ddszatkowski/Automated-Gardening-System/EE-CpE 4097 Automated Gardening System - Final Presentation.pdf

# Automated Gardening System (AGS)

# EE-CpE 4097

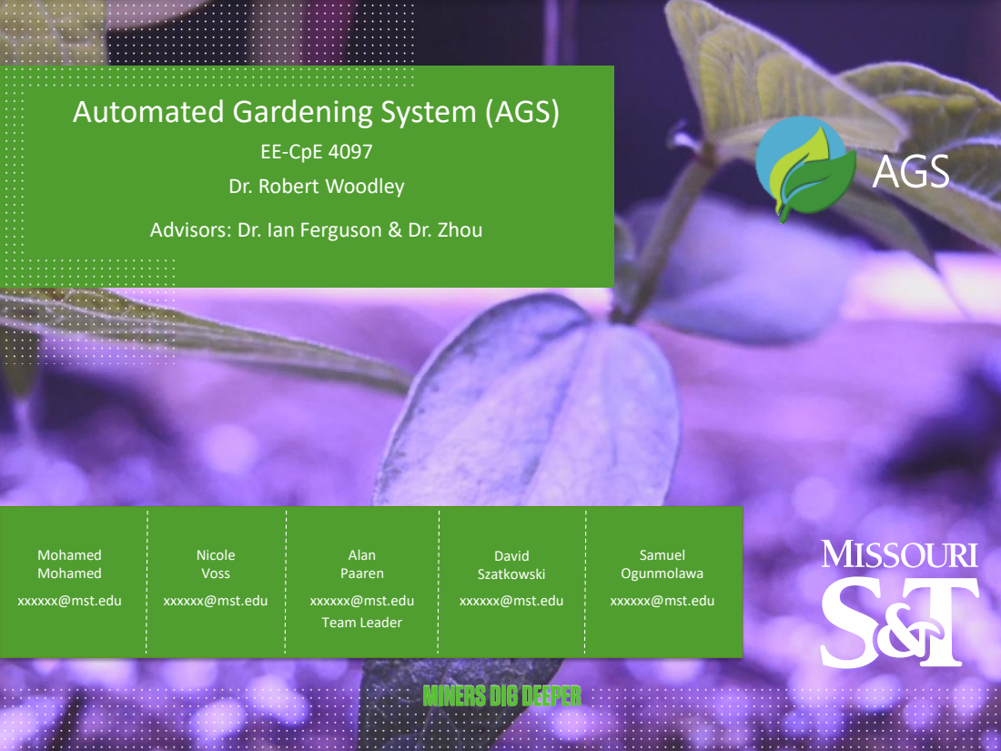
[picture p36: page 1]
AGS

Dr. Robert Woodley

Advisors: Dr. Ian Ferguson & Dr. Zhou

Mohamed
xxxxxx@mst.edu

Nicole
Voss

Alan
Paaren
Team Leader

David
Szatkowski

Samuel
Ogunmolawa

- Overview – Goals – Motivation – Value • Progress – Entire System – Sound Frequency System – Ventilation System – Lighting System – Watering System – Nutrient Dosing System – User Interface • Results – Plant Visuals – Graphs • Lessons Learned • References

# OUTLINE

EE

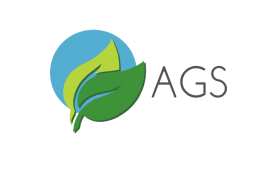
[picture p37: figure]

-CpE 4097 | AGS

2

OVERVIEW | AGS

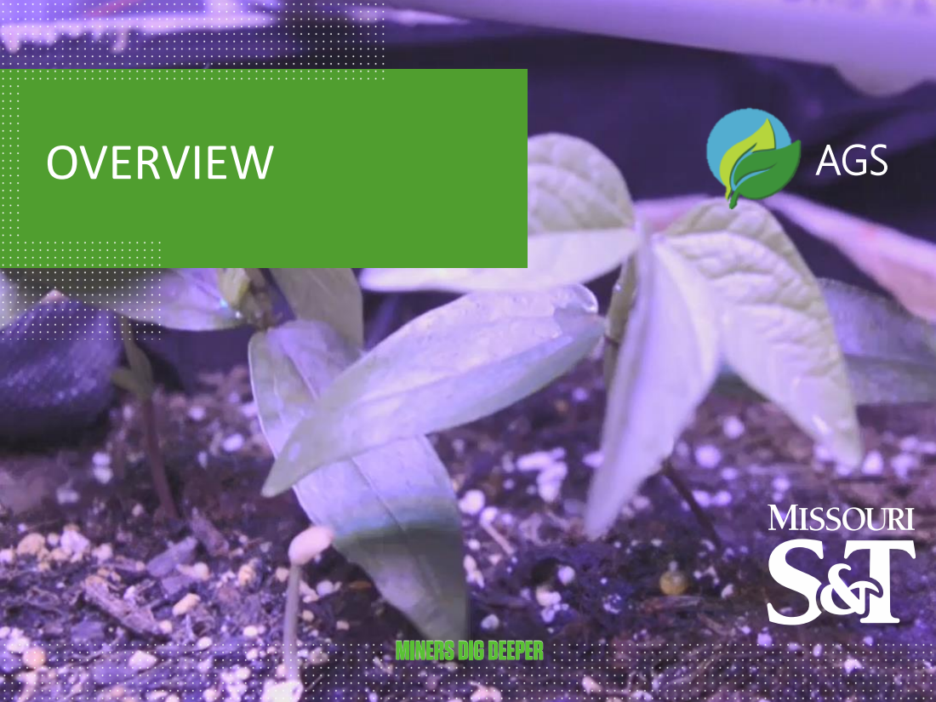
[picture p38: page 3]

# OVERVIEW - GOALS

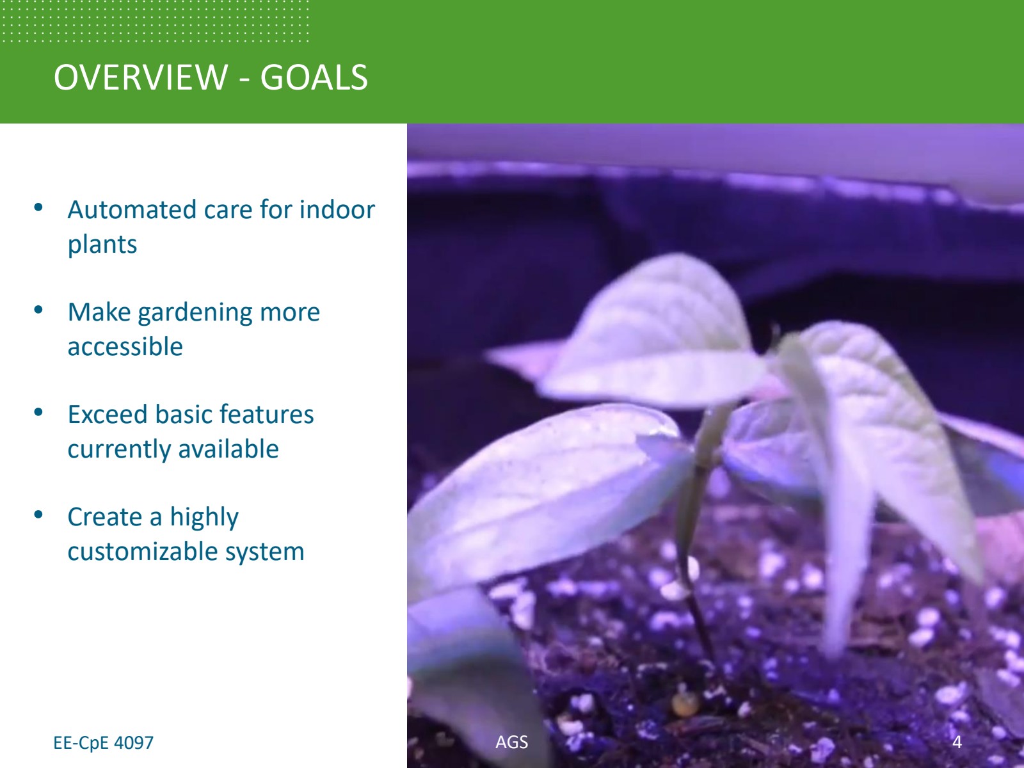
[picture p39: page 4]

# - Automated care for indoor plants

# - Make gardening more accessible

# - Exceed basic features currently available

# - Create a highly customizable system

EE-CpE 4097 | AGS | 4

# OVERVIEW - MOTIVATION

# - Increased demand for

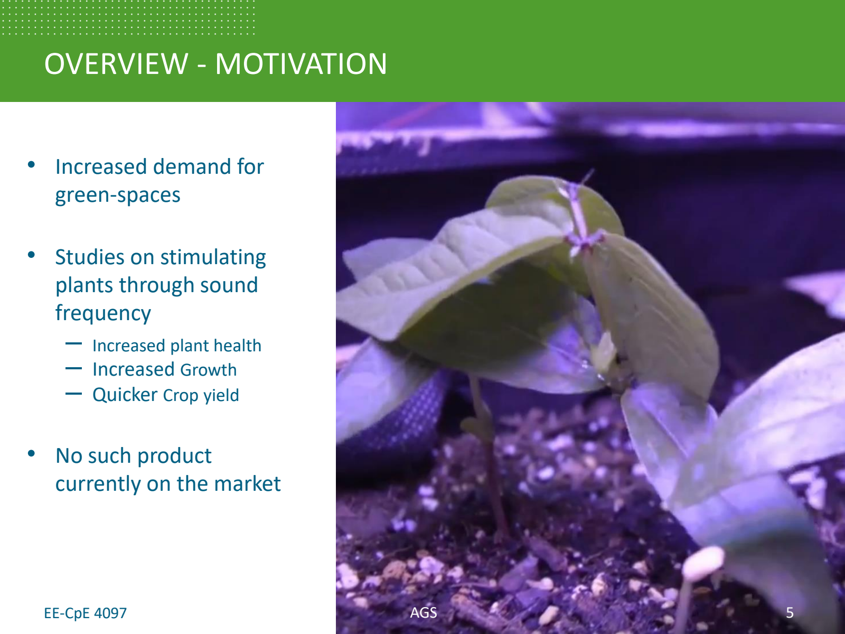
[picture p40: page 5]

# green-spaces

# - Studies on stimulating plants through sound frequency

# – Increased plant health

# – Increased Growth

# – Quicker Crop yield

# - No such product currently on the market

EE-CpE 4097 | AGS | 5

# OVERVIEW - VALUE

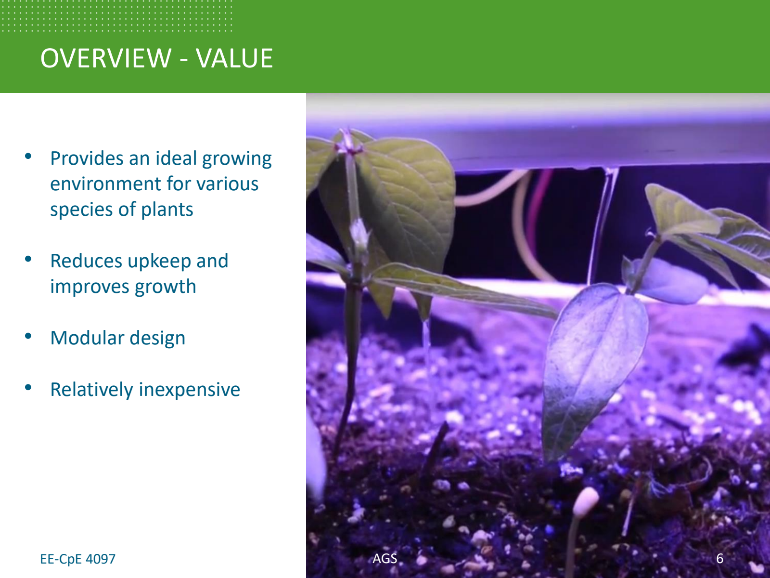
[picture p41: page 6]

# - Provides an ideal growing environment for various species of plants

# - Reduces upkeep and improves growth

# - Modular design

# - Relatively inexpensive

EE-CpE 4097 | AGS | 6

PROGRESS | AGS

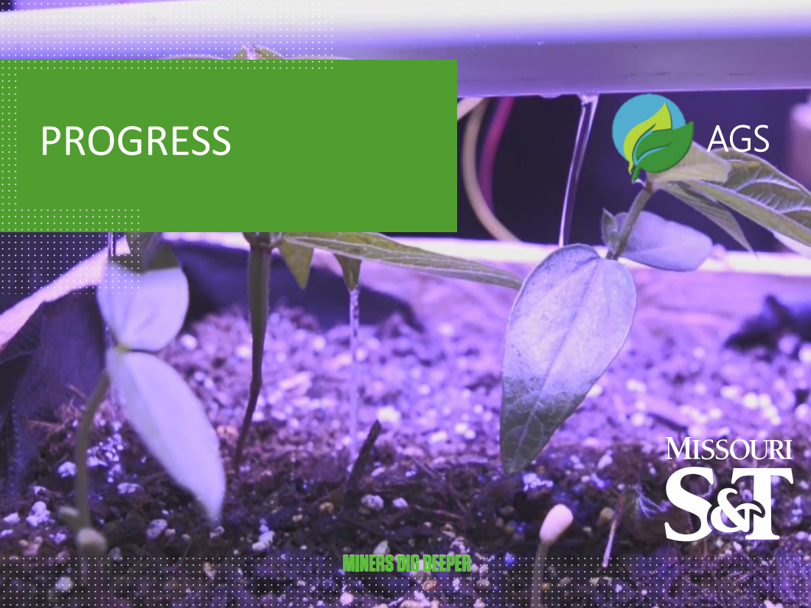
[picture p42: page 7]

# PROGRESS – ENTIRE SYSTEM

# The Automated Garden consists of:

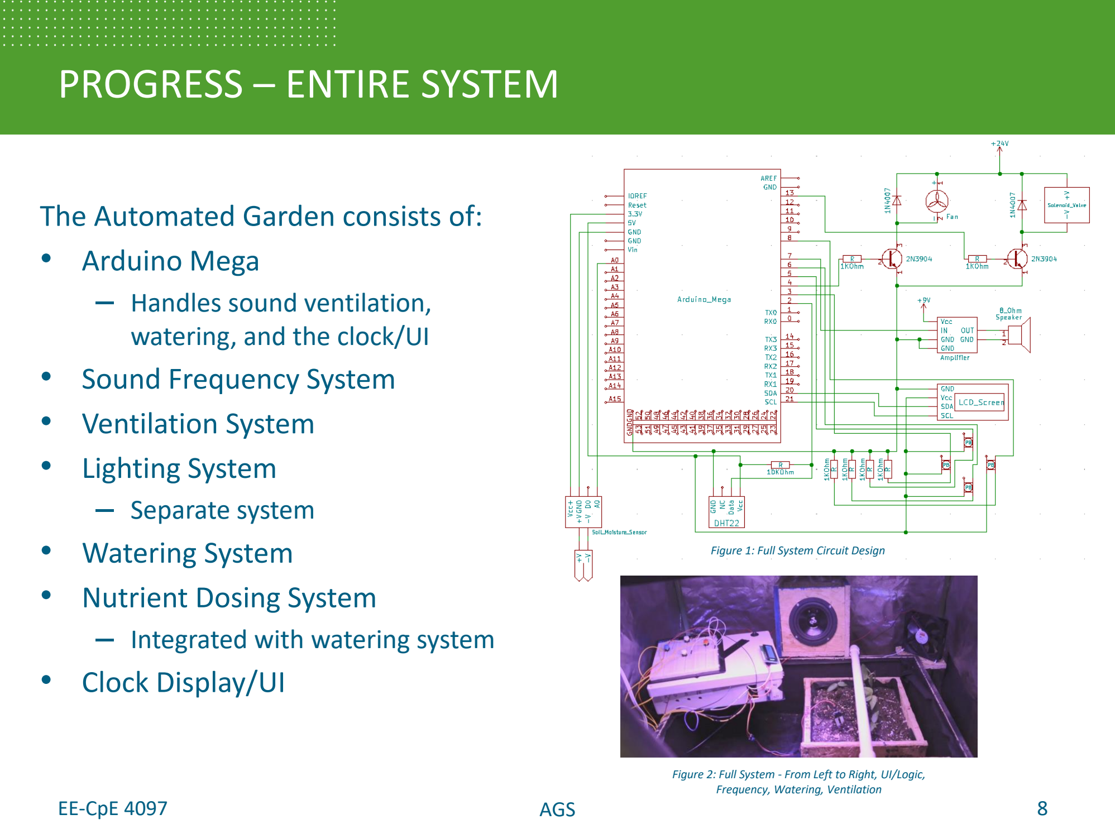
[picture p43: page 8]

AGS | 8

Figure 2: Full System - From Left to Right, UI/Logic, Frequency, Watering, Ventilation

Figure 1: Full System Circuit Design

## EE-CpE 4097

# - Arduino Mega

– Handles sound ventilation,

# watering, and the clock/UI

# - Sound Frequency System - Ventilation System - Lighting System

# – Separate system

# - Watering System - Nutrient Dosing System

# – Integrated with watering system

# - Clock Display/UI

# - We use several libraries

– Handle DHT sensor, RTC setup,

# Alarm setup, LCD screen

# - Initialize a lot of variables, and define several pins before and during void setup()

# – setTime(16,0,0,10,30,19) sets the clock to 4PM Oct 30, 2019

# - Once void setup() has run once, void loop() repeatedly calls

# – ButtonCheck()

# - Looks for button inputs every .1 sec

# – Alarm.delay()

# - Constantly checks if an alarm has expired

# PROGRESS – ENTIRE SYSTEM CODE

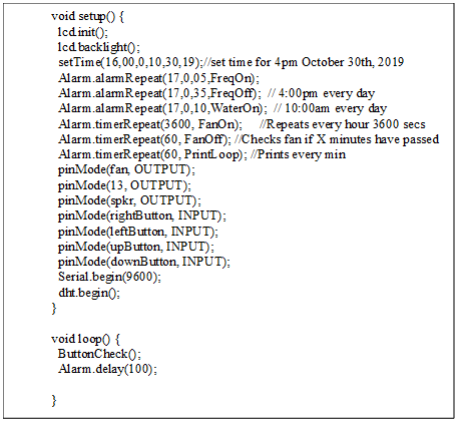
[picture p44: figure]

Figure 3: Entire system code

# PROGRESS – SOUND FREQUENCY SYSTEM

# - Automation

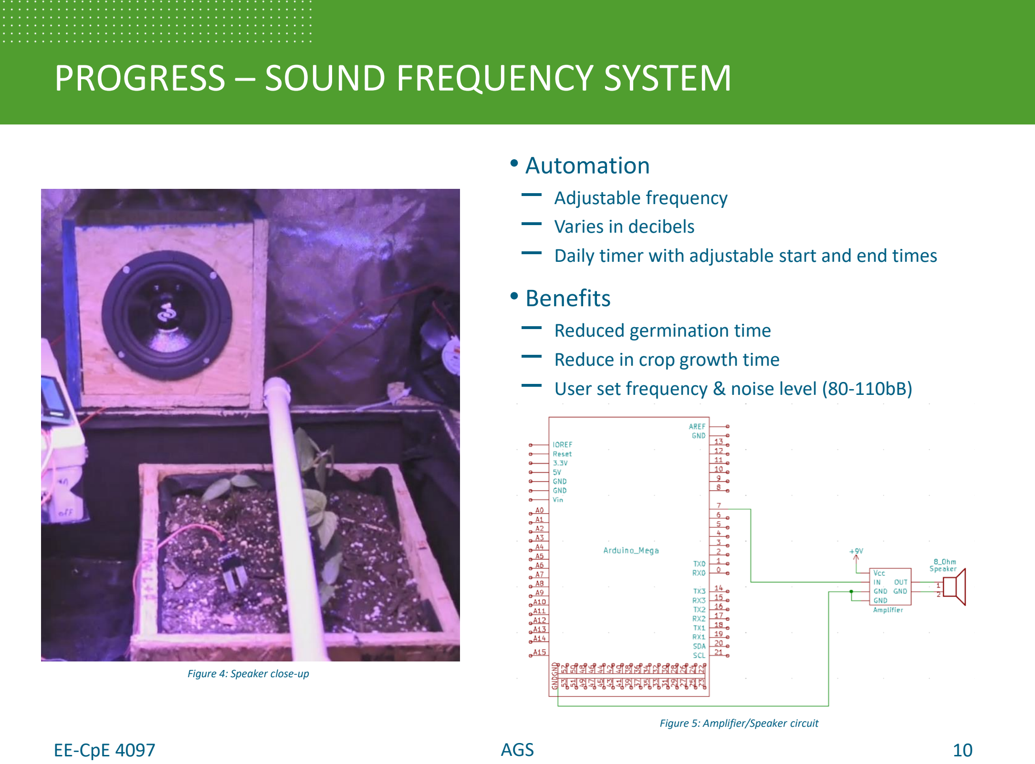
[picture p45: page 10]

## – Adjustable frequency – Varies in decibels – Daily timer with adjustable start and end times

# - Benefits

## – Reduced germination time – Reduce in crop growth time – User set frequency & noise level (80-110bB)

Figure 4: Speaker close-up

Figure 5: Amplifier/Speaker circuit

# PROGRESS – SOUND FREQUENCY SYSTEM CODE

Figure 6: Frequency code

const int freq = 2700;
setTime(16,0,0,10,30,19);//set time for 4pm October 30th, 2019 Alarm.alarmRepeat(13,0,0,FreqOn); Alarm.alarmRepeat(13,0,30,FreqOff); // 4:00pm every day pinMode(spkr, OUTPUT);

//Timer for speaker
void FreqOn() {
// write here the task to perform every morning Serial.println("Sound on");

tone(spkr, freq);
}

void FreqOff() {
//write here the task to perform every evening Serial.println("Sound off");
noTone(spkr);
}

# - In setup, two daily alarms are set to call functions that start and stop toggling the speaker

# – FreqOn() / FreqOff()

# - tone(spkr, freq) toggles the spkr pin on/off at a rate of 2700 Hz until noTone(spkr) is called

# – Adjustable via the freq variable

# - During testing, we stimulated plants from 1PM to 5PM

# - This example runs for 30 sec after 1PM

# PROGRESS – VENTILATION SYSTEM

# - Provides proper air ventilation

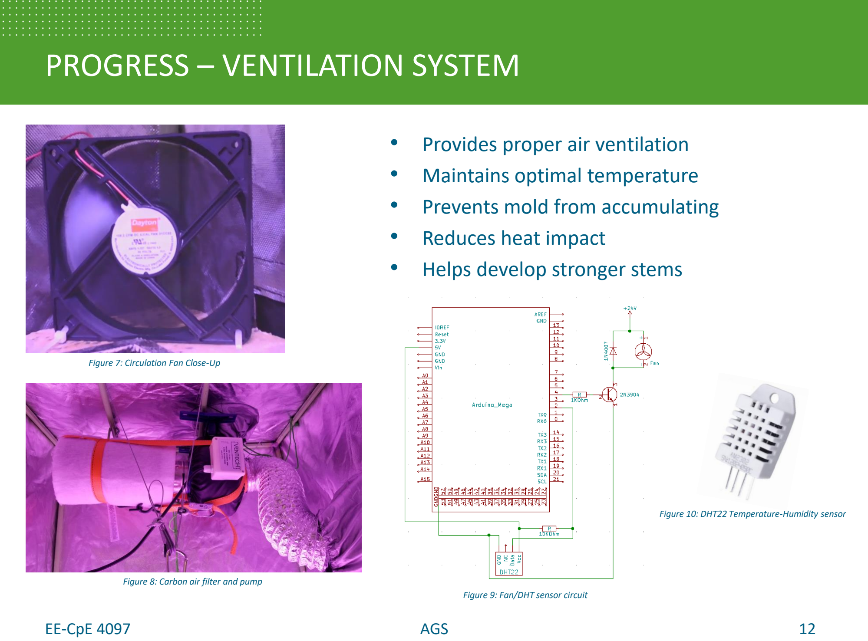
[picture p46: page 12]

# - Maintains optimal temperature - Prevents mold from accumulating - Reduces heat impact - Helps develop stronger stems

Figure 7: Circulation Fan Close-Up

Figure 9: Fan/DHT sensor circuit

Figure 10: DHT22 Temperature-Humidity sensor

Figure 8: Carbon air filter and pump

# PROGRESS – VENTILATION SYSTEM CODE

# - The ventilation system uses a repeating timer to handle the fan

# - FanOn is called every hour and turns the fan on

# - FanOff is called every minute and 10 minutes after FanOn was called turns the fan off

# - PrintLoop() checks sensors, prints troubleshooting info to the serial monitor, and turns the fan on if the DHT sensor reads too hot or humid

EE-CpE 4097 | AGS | 13

#include <TimeAlarms.h>

#include <Time.h>

#include <TimeLib.h>

#include <DHT.h>

#define DHTPIN 2 // what pin we're connected to #define DHTTYPE DHT22 // DHT 22 (AM2302) #define fan 4

int fanCount = 11;
int maxHum = 60;
int maxTemp = 74;
DHT dht(DHTPIN, DHTTYPE);

void setup() {
setTime(16,0,0,11,21,19);//set time for 4pm October 30th, 2019 Alarm.timerRepeat(3600, FanOn); //Repeats every hour 3600 secs Alarm.timerRepeat(60, FanOff); //Checks every minute Alarm.timerRepeat(60, PrintLoop);
pinMode(fan, OUTPUT);
Serial.begin(9600);
dht.begin();
}

Figure 11: Ventilation system code

# PROGRESS – VENTILATION SYSTEM CODE

# - The code checks values from the

DHT22 temperature-humidity sensor.

# - Activates fan if the sensor readings exceed maxTemp or maxHum

# - Temperature was set at 74˚ F

# - Humidity was set at 60%

# - Fan turns off once readings are back

below those values.

Figure 5: Fan Close-Up

Figure 12: Ventilation system code

void PrintLoop()
{
sensorValue = analogRead(sensorPin); Serial.println("Analog Value : "); Serial.println(sensorValue);
float h = dht.readHumidity();
// Read temperature as Celsius
float t = dht.readTemperature();
float TempF = (t*1.8)+32;
// Check if any reads failed and exit early (to try again). if (isnan(h) || isnan(t)) {
Serial.println("Failed to read from DHT sensor!"); return;
}
if (h > maxHum || TempF > maxTemp) { digitalWrite(fan, HIGH);
Serial.print("Turning on Fan it's hot! "); } else if(fanCount > 10) { digitalWrite(fan, LOW);
}
Serial.print("Day count: "); Serial.print(daycount);
Serial.print(" \t");
Serial.print("Humidity: "); Serial.print(h);
Serial.print(" %\t");
Serial.print("Temperature: "); Serial.print(TempF);
Serial.println(" *F ");
}

# PROGRESS – VENTILATION SYSTEM CODE

# - FanOn()

# – Turns on fan, starts a counter for FanOff()

# - FanOff()

– Once counter reaches 10 min,

# turns off fan

Figure 13: FanOn() and FanOff() code

void FanOn() {
float h = dht.readHumidity(); // Read temperature as Celsius float t = dht.readTemperature(); float TempF = (t*1.8)+32;
Serial.print("Turning on Fan"); digitalWrite(fan, HIGH);

fanCount = 0;
}

void FanOff(){
if(fanCount == 10){
digitalWrite(fan, LOW);
Serial.print("Fan Turned Off"); }
if(fanCount <= 11)
{
Serial.print("Fan on for "); Serial.print(fanCount);
Serial.print("minutes.");
fanCount++;
}

# PROGRESS – LIGHTING SYSTEM

# - Full-Spectrum LEDs w/ spectrum control provide an optimum wavelength of light throughout the entire growth cycle

# - System operates independently using values provided through an IR remote

# - Programmable controls allow fully-customizable settings

# - Daisy-chain feature provides simplicity and scalability


Figure 14: LED Array Close-Up

# PROGRESS – WATERING SYSTEM

# - Controlled by soil moisture sensor

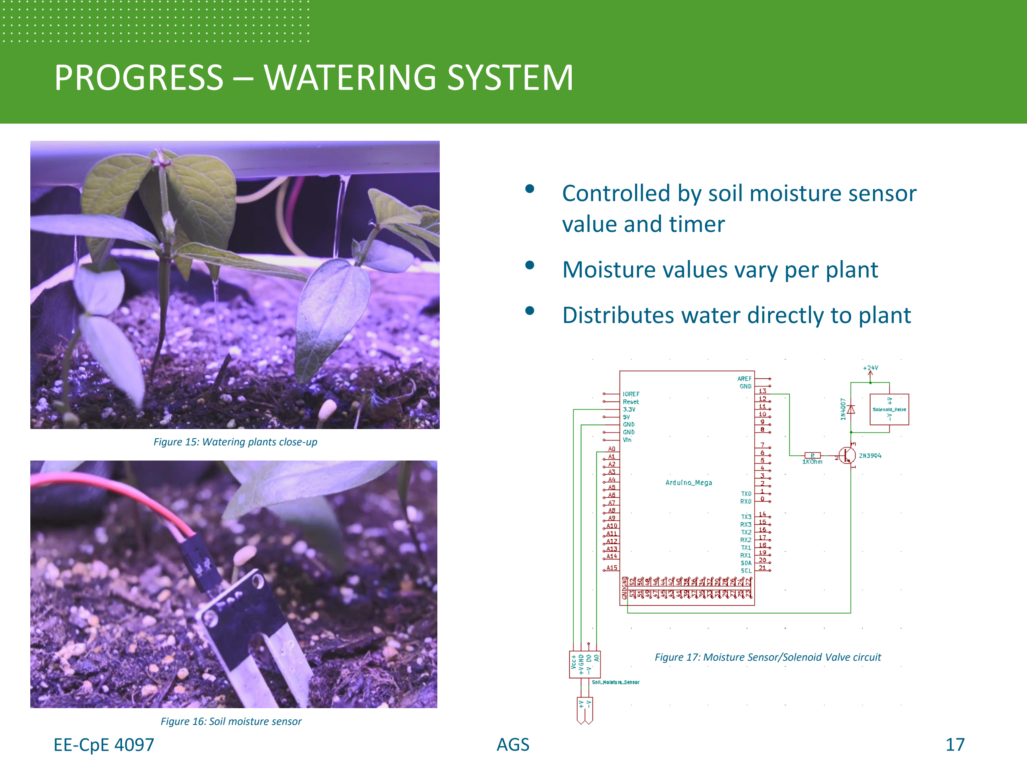
[picture p47: page 17]

# value and timer - Moisture values vary per plant

# - Distributes water directly to plant

Figure 15: Watering plants close-up

Figure 16: Soil moisture sensor

Figure 17: Moisture Sensor/Solenoid Valve circuit

# PROGRESS – WATERING SYSTEM CODE

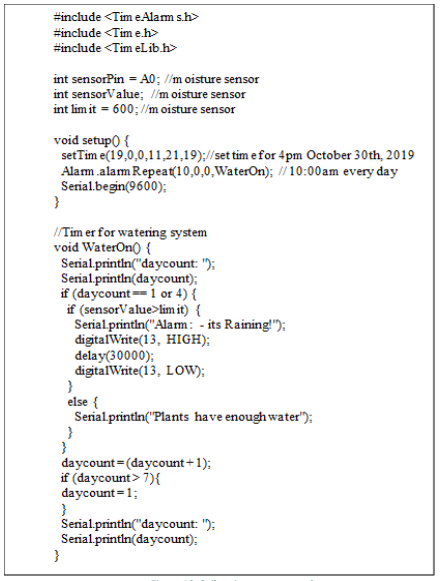
[picture p48: figure]

Figure 18: Soil moisture sensor code

# - Reads values sent from the soil moisture sensor from the assigned

analog pin.

# - When the timer reaches a pre-set time, the timer calls WaterOn()

# - WaterOn() uses a counter to check twice weekly if the soil moisture is below the desired value

# - If the value is too low, the valve opens for 30 sec

# PROGRESS – NUTRIENT DOSING SYSTEM

# - Dosage depends on the plant species

# – Optimal ratio for mung beans

(1 - 0.5 - 1.59)

# – Ratio achieved was (1 - 0.5 - 1.7)

# - Adjusted across each stage of the growing cycle

# – Recommended frequency is every other watering

# - Uniformly distributed across the plot through the watering system

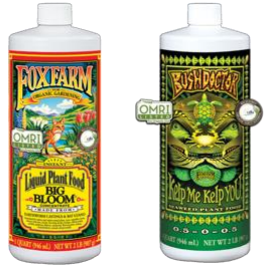
[picture p49: figure]

Figure 19: Liquid Nutrient Additives

# PROGRESS – USER INTERFACE

# - An LCD screen and button interface

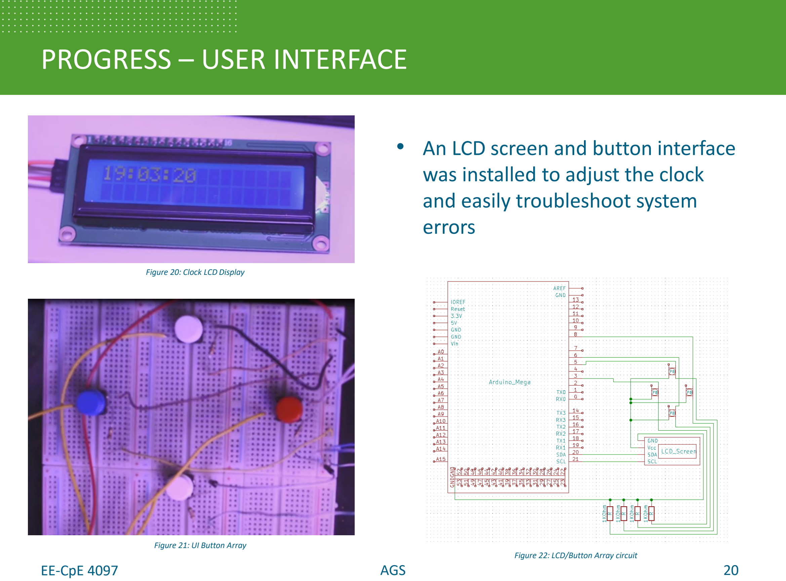
[picture p50: page 20]

# was installed to adjust the clock and easily troubleshoot system errors

Figure 20: Clock LCD Display

Figure 21: UI Button Array Figure 22: LCD/Button Array circuit

# PROGRESS – USER INTERFACE

# - ButtonCheck() is called every 100ms and checks for button presses

# - If a button is pressed, it calls the related function

– RightButton(), LeftButton(), etc.

# - Also calls digitalClockDisplay() to print the clock to the LCD screen

Figure 23: Checking for Button Presses

void ButtonCheck(){
buttonStateRight = digitalRead(rightButton); buttonStateLeft = digitalRead(leftButton); buttonStateUp = digitalRead(upButton); buttonStateDown = digitalRead(downButton); if (buttonStateRight == HIGH) { RightButton();
} else if (buttonStateRight == LOW) {
right = 0;
}
if (buttonStateLeft == HIGH) { LeftButton();
} else {
left = 0;
}
if (buttonStateUp == HIGH) { UpButton();
} else {
up = 0;
}
if (buttonStateDown == HIGH) { DownButton();
} else {
down = 0;
}
digitalClockDisplay();
}

# PROGRESS – USER INTERFACE

# - Functions scroll the cursor left and right or adjust the clock up or down

Figure 25: Manually Setting the RTC

void RightButton(){
if (right == 0) {
if(clockCursor < 7){
clockCursor++;
if(clockCursor == 2 or clockCursor == 5) clockCursor++;
}
else
clockCursor = -1;
}
right = 1;
}
void LeftButton(){
if (left == 0) {
if(clockCursor > -1){
clockCursor--;
if(clockCursor == 2 or clockCursor == 5) clockCursor--;
}
else
clockCursor = 7;
}
left = 1;
}

void UpButton(){
if (up == 0) {
if(clockCursor == 0)
adjustTime(36000);
else if(clockCursor == 1)
adjustTime(3600);
else if(clockCursor == 3)
adjustTime(600);
else if(clockCursor == 4)
adjustTime(60);
else if(clockCursor == 6)
adjustTime(10);
else if(clockCursor == 7)
adjustTime(1);
}
up = 1;
}
void DownButton(){
if (down == 0) {
if(clockCursor == 0)
adjustTime(-36000);
else if(clockCursor == 1)
adjustTime(-3600);
else if(clockCursor == 3)
adjustTime(-600);
else if(clockCursor == 4)
adjustTime(-60);
else if(clockCursor == 6)
adjustTime(-10);
else if(clockCursor == 7)
adjustTime(-1);
}
Figure 24: Cursor Handling | down = 1;

# PROGRESS – USER INTERFACE

# - Formats and prints current time to LCD

Figure 27: Formatting Printing void digitalClockDisplay() {
// digital clock display of the time Serial.print(hour());
printDigits(minute());
printDigits(second());
lcd.setCursor(0,0);
if(hour() < 10)
{
lcd.print(0);
lcd.setCursor(1,0);
}
lcd.print(hour());
printLCDmin(minute());
printLCDsec(second());
Serial.println();
lcd.setCursor(0, 1);
lcd.print(" | ");
if(clockCursor >= 0)
{
lcd.setCursor(clockCursor, 1); lcd.print('^');
}
}

void printDigits(int digits) { Serial.print(":");
if (digits < 10)
Serial.print('0');
Serial.print(digits);
}
void printLCDmin(int digits) { lcd.setCursor(2,0);
lcd.print(":");
lcd.setCursor(3,0);
if (digits < 10)
{
lcd.print('0');
lcd.setCursor(4,0);
}
lcd.print(digits);
}
void printLCDsec(int digits) { lcd.setCursor(5,0);
lcd.print(":");
lcd.setCursor(6,0);
if (digits < 10)
{
lcd.print('0');
lcd.setCursor(7,0);
}
lcd.print(digits);
}

Figure 26: Printing Clock to LCD and Serial Monitor

# PROGRESS – SYSTEM DEMO

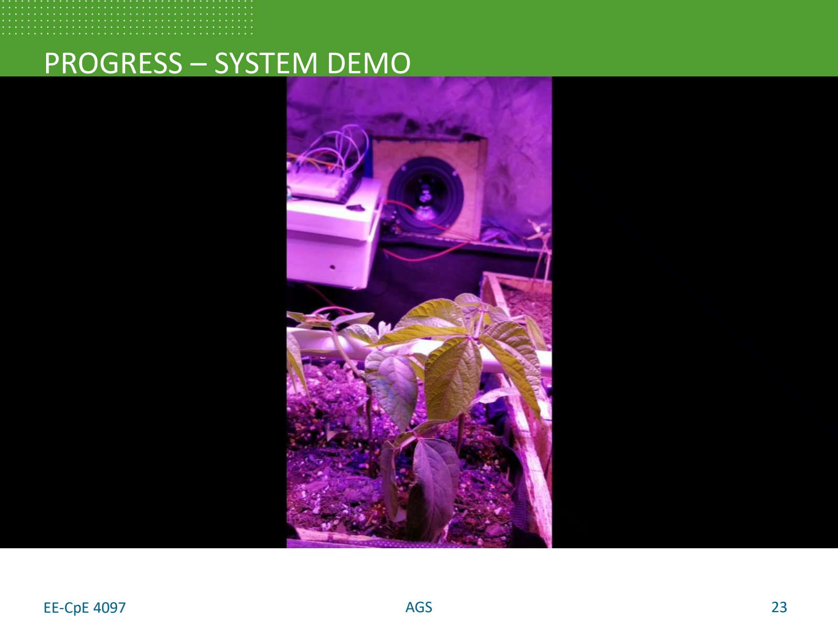
[picture p51: page 24]

EE-CpE 4097 | AGS | 23

RESULTS | AGS

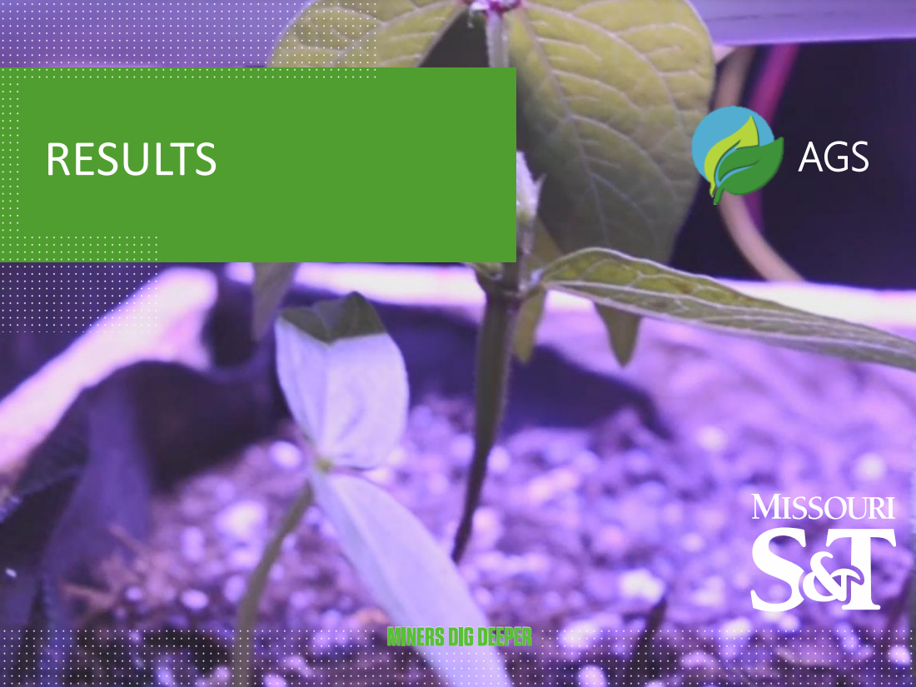
[picture p52: page 25]

# RESULTS – PLANT VISUALS

# The batch of tests contained 3 groups including:

# - 4 hours of 2.7kHz frequency at ~80dB & 18 hours of full spectrum lighting - No frequency stimulation & 18 hours of full spectrum lighting - Indoor control group

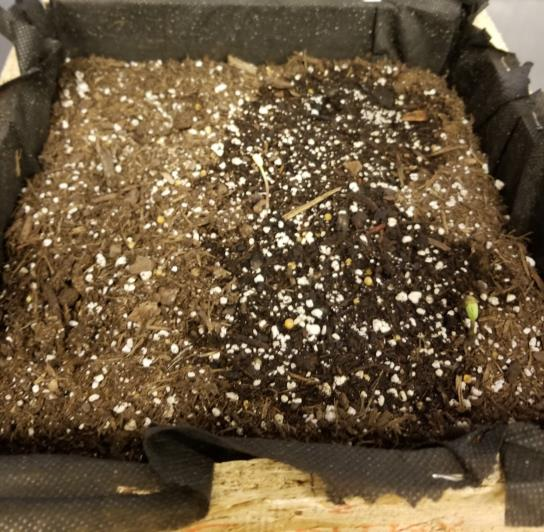
[picture p53: figure]

Control Group | Lighting Only | Lighting & Frequency

Figure 29: Lighting
| System Stress Testing Results
Figure 28: Control System Testing Results | Figure 30: Lighting and frequency System Stress Testing Results

# RESULTS – GRAPHS

# Mung beans that received 4 hours of 2.7kHz frequency stimulation and 18 hours of full spectrum lighting grew:

# - 47.7% taller than the group that did not receive frequency stimulation - 84.3% taller than the indoor control group

# These mung beans had an average stem width that was:

# - 64% ticker than the group that did not receive frequency stimulation - 76% thicker than the indoor control group

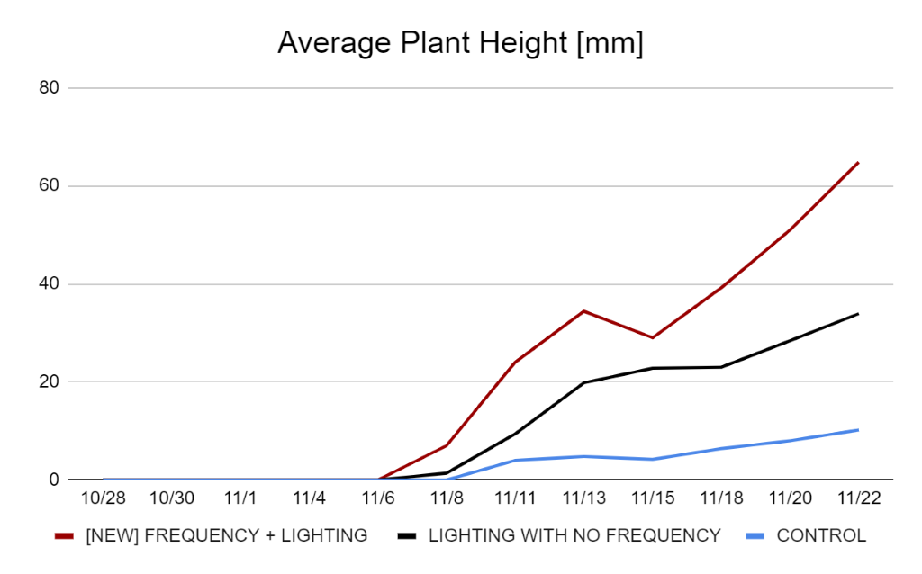
[picture p54: figure]

Figure 31: Plant Height Over Time


Figure 32: Stem Width Over Time

# RESULTS – GRAPHS

# Mung beans that received 4 hours of 2.7kHz frequency stimulation and 18 hours of full spectrum lighting grew:

# - 71.4% more leaves than the group that did not receive frequency stimulation - 100% more leaves than the control group

# These mung beans had average leaf length that was:

# - 43% longer than the group that had only received the lighting treatment - 100% longer than the control group

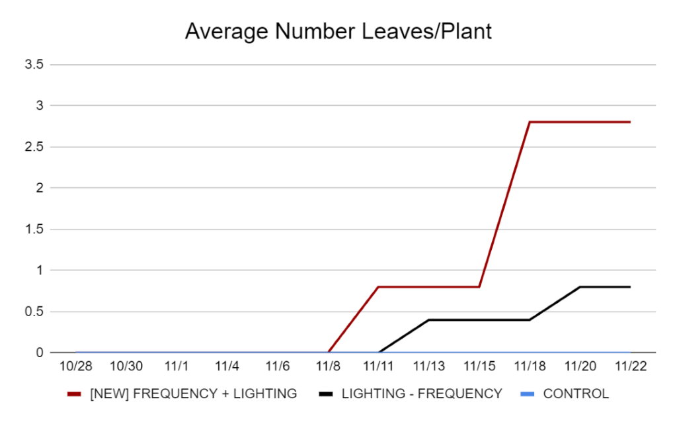
[picture p55: figure]

Figure 33: Average # Leaves Over Time

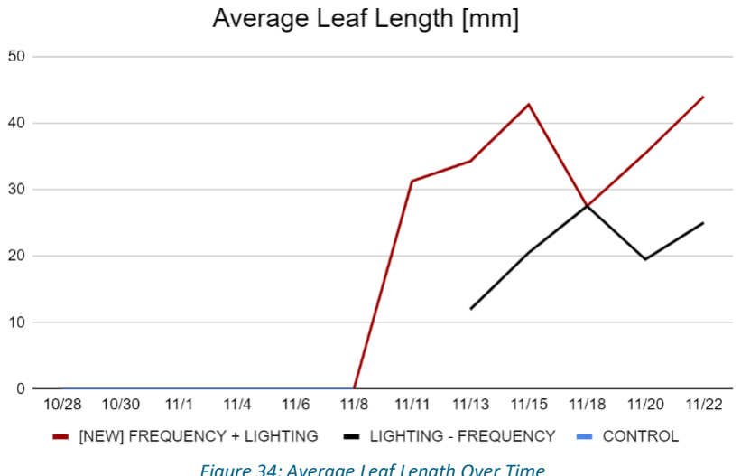
[picture p56: figure]

Figure 34: Average Leaf Length Over Time

LESSONS LEARNED | AGS

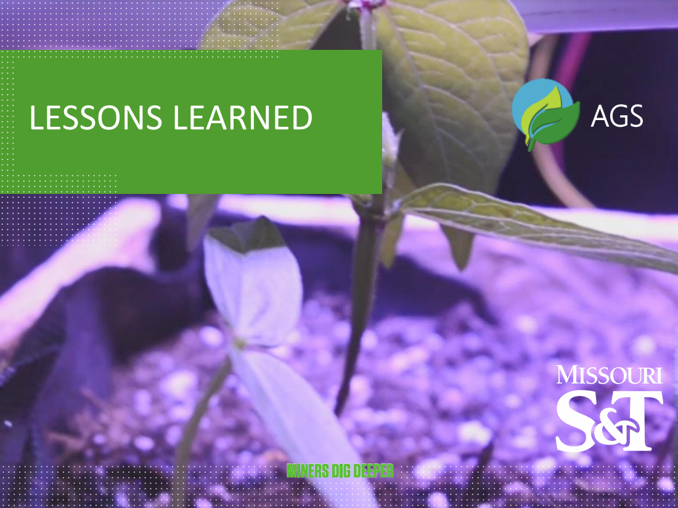
[picture p57: page 29]

# LESSONS LEARNED

# - Plan ahead

– Despite all the issues we weren’t prepared for...

# - Components fried - Some parts were unable to handle the system stress required - Needed additional power source

# - Enlist an expert

# – Most of our knowledge came from individual research of the systems

# - Our team was missing a background in the science of gardening - Bad gardening could lead to bad data

# – Get input from a horticulturalist or agriculturalist

EE-CpE 4097 | AGS | 30

# REFERENCES

[1] J. McGrath, “Eight Devices to Help You Grow a Garden Indoors,” Digital Trends, Jan. 16, 2019. [Online]. Available: https://www.digitaltrends.com/home/indoor-garden-devices/. [Accessed: Feb. 10, 2019].
[2] W. Cai, H. He, S. Zhu, and N. Wang, “Biological Effect of Audible Sound Control on Mung Bean (Vigna

## radiate) Sprout,” BioMed Research International, vol. 2014, pp. 1–6, Aug. 2014

EE-CpE 4097 | AGS | 20

# Automated Gardening System (AGS)

# AGS

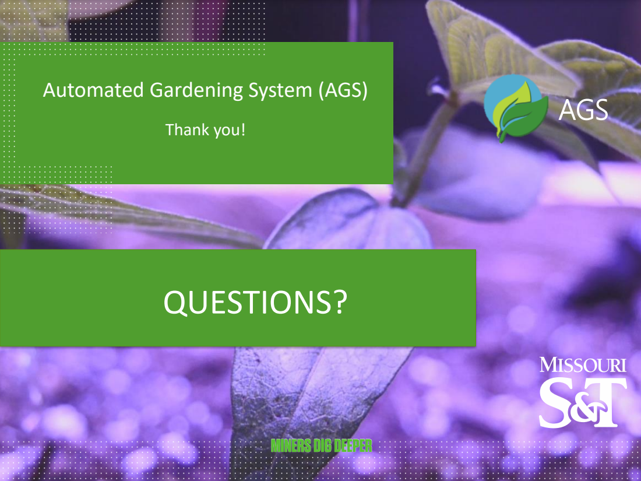
[picture p58: page 32]
Thank you!; QUESTIONS?
